annaburds/x-heep/tb/testharness_pkg.sv

// Copyright 2022 EPFL
// Solderpad Hardware License, Version 2.1, see LICENSE.md for details.
// SPDX-License-Identifier: Apache-2.0 WITH SHL-2.1

package testharness_pkg;

  import addr_map_rule_pkg::*;
  import core_v_mini_mcu_pkg::*;

  localparam EXT_XBAR_NMASTER = 5;
  localparam EXT_XBAR_NSLAVE = 2;

  //master idx
  localparam logic [31:0] EXT_MASTER0_IDX = 0;
  localparam logic [31:0] EXT_MASTER1_IDX = 1;
  localparam logic [31:0] EXT_MASTER2_IDX = 2;
  localparam logic [31:0] EXT_MASTER3_IDX = 3;
  localparam logic [31:0] EXT_MASTER4_IDX = 4;  // serial link external master

  //slave mmap and idx
  localparam logic [31:0] SLOW_MEMORY_START_ADDRESS = core_v_mini_mcu_pkg::EXT_SLAVE_START_ADDRESS+ 32'h0;
  localparam logic [31:0] SLOW_MEMORY_SIZE = 32'h200;
  localparam logic [31:0] SLOW_MEMORY_END_ADDRESS = SLOW_MEMORY_START_ADDRESS + SLOW_MEMORY_SIZE;
  localparam logic [31:0] SLOW_MEMORY_IDX = 32'd0;

  //slave sl
  localparam logic [31:0] SL_EXT_START_ADDRESS = core_v_mini_mcu_pkg::EXT_SLAVE_START_ADDRESS + 32'h10000;
  localparam logic [31:0] SL_EXT_SIZE = 32'h200;
  localparam logic [31:0] SL_EXT_END_ADDRESS = SL_EXT_START_ADDRESS + SL_EXT_SIZE;
  localparam logic [31:0] SL_EXT_IDX = 32'd1;


  localparam addr_map_rule_t [EXT_XBAR_NSLAVE-1:0] EXT_XBAR_ADDR_RULES = '{
      '{
          idx: SLOW_MEMORY_IDX,
          start_addr: SLOW_MEMORY_START_ADDRESS,
          end_addr: SLOW_MEMORY_END_ADDRESS
      },
      '{idx: SL_EXT_IDX, start_addr: SL_EXT_START_ADDRESS, end_addr: SL_EXT_END_ADDRESS}
  };

  //slave encoder
  localparam EXT_NPERIPHERALS = 5;

  // Memcopy controller (external peripheral example)
  localparam logic [31:0] MEMCOPY_CTRL_START_ADDRESS = core_v_mini_mcu_pkg::EXT_PERIPHERAL_START_ADDRESS + 32'h0;
  localparam logic [31:0] MEMCOPY_CTRL_SIZE = 32'h10;
  localparam logic [31:0] MEMCOPY_CTRL_END_ADDRESS = MEMCOPY_CTRL_START_ADDRESS + MEMCOPY_CTRL_SIZE;
  localparam logic [31:0] MEMCOPY_CTRL_IDX = 32'd0;

  // External AMS Peripheral
  localparam logic [31:0] AMS_START_ADDRESS = core_v_mini_mcu_pkg::EXT_PERIPHERAL_START_ADDRESS + 32'h01000;
  localparam logic [31:0] AMS_SIZE = 32'h100;
  localparam logic [31:0] AMS_END_ADDRESS = AMS_START_ADDRESS + AMS_SIZE;
  localparam logic [31:0] AMS_IDX = 32'd1;

  // External InterFaced FIFO (IFFIFO) Peripheral
  localparam logic [31:0] IFFIFO_START_ADDRESS = core_v_mini_mcu_pkg::EXT_PERIPHERAL_START_ADDRESS + 32'h02000;
  localparam logic [31:0] IFFIFO_SIZE = 32'h100;
  localparam logic [31:0] IFFIFO_END_ADDRESS = IFFIFO_START_ADDRESS + IFFIFO_SIZE;
  localparam logic [31:0] IFFIFO_IDX = 32'd2;

  // External Simple Accelerator Peripheral
  localparam logic [31:0] SIMPLE_ACC_START_ADDRESS = core_v_mini_mcu_pkg::EXT_PERIPHERAL_START_ADDRESS + 32'h03000;
  localparam logic [31:0] SIMPLE_ACC_SIZE = 32'h100;
  localparam logic [31:0] SIMPLE_ACC_END_ADDRESS = SIMPLE_ACC_START_ADDRESS + SIMPLE_ACC_SIZE;
  localparam logic [31:0] SIMPLE_ACC_IDX = 32'd3;
  localparam logic [31:0] SL_REG_START_ADDRESS= core_v_mini_mcu_pkg::EXT_PERIPHERAL_START_ADDRESS+ 32'h04000;
  localparam logic [31:0] SL_REG_SIZE = 32'h200;
  localparam logic [31:0] SL_REG_END_ADDRESS = SL_REG_START_ADDRESS + SL_REG_SIZE;
  localparam logic [31:0] SL_REG_IDX = 32'd4;

  localparam addr_map_rule_t [EXT_NPERIPHERALS-1:0] EXT_PERIPHERALS_ADDR_RULES = '{
      '{
          idx: MEMCOPY_CTRL_IDX,
          start_addr: MEMCOPY_CTRL_START_ADDRESS,
          end_addr: MEMCOPY_CTRL_END_ADDRESS
      },
      '{idx: AMS_IDX, start_addr: AMS_START_ADDRESS, end_addr: AMS_END_ADDRESS},
      '{idx: IFFIFO_IDX, start_addr: IFFIFO_START_ADDRESS, end_addr: IFFIFO_END_ADDRESS},
      '{
          idx: SIMPLE_ACC_IDX,
          start_addr: SIMPLE_ACC_START_ADDRESS,
          end_addr: SIMPLE_ACC_END_ADDRESS
      },
      '{idx: SL_REG_IDX, start_addr: SL_REG_START_ADDRESS, end_addr: SL_REG_END_ADDRESS}
  };

  localparam int unsigned EXT_PERIPHERALS_PORT_SEL_WIDTH = EXT_NPERIPHERALS > 1 ? $clog2(
      EXT_NPERIPHERALS
  ) : 32'd1;

endpackage
