annaburds/x-heep/sw/applications/example_seizureDetCNN_EE_avgPool_fc/main.c

// Porting to X-Heep : Francesco Poluzzi
/*
 *  Copyright (c) [2024] [Embedded Systems Laboratory (ESL), EPFL]
 *
 *  Licensed under the Apache License, Version 2.0 (the License);
 *  you may not use this file except in compliance with the License.
 *  You may obtain a copy of the License at
 *
 *      http://www.apache.org/licenses/LICENSE-2.0
 *
 *  Unless required by applicable law or agreed to in writing, software
 *  distributed under the License is distributed on an AS IS BASIS,
 *  WITHOUT WARRANTIES OR CONDITIONS OF ANY KIND, either express or implied.
 *  See the License for the specific language governing permissions and
 *  limitations under the License.
 */


//////////////////////////////////////////////////////
// Main Author:     Alireza Amirshahi               //
// Optimizations:   Dimitrios Samakovlis            //
/////////////////////////////////////////////////////



#include "main.h"
#include <stdio.h>
#include "timer_sdk.h"

// Enable the C level optimizations for performance gains (loop reordering - loop unrolling)
#define CONV_OPTIMIZED
#define CONV_MAX_OPTIMIZED	// this has the most significant gains as it is the most time consuming part
#define BATCH_OPTIMIZED

#define MAX_INT_16 65535

int16_t intermediate_map[256*128];

    
// ===========================> Functions Prototype <===============================
void conv1d(const int16_t *data, const signed char *filter, int16_t *map_out, const signed char *bias, int32_t filter_size,
            int32_t input_len, int32_t input_depth, int32_t output_len, int32_t n_filter, int32_t strides, int32_t relu);

void conv_max1d(const int16_t *data, const signed char *filter, int16_t *map_out, const signed char *bias,
                int32_t input_len, int32_t input_depth, int32_t output_len);

void batch_normalization(const int16_t *data, const signed char *gamma, const signed char *beta, const signed char *mean, const signed char *var,
                         int16_t *map_out, int32_t input_len);

int16_t forward_propagation(int16_t *data, int16_t *intermediate);

// =================================================================================

int main()
{
    #ifdef PRINT_CYCLES
        timer_init();
        timer_start();
    #endif

    int16_t predict = forward_propagation(input_array, intermediate_map);

    #ifdef PRINT_OUTPUT
    printf("Prediction : %d", predict);
    if (predict == 0)
        printf(" (Normal)\n");
    else
        printf(" (Seizure)\n");
    #endif

    #ifdef PRINT_CYCLES
        uint32_t cycles=timer_stop();
        printf("Cycles: %d\n",cycles);
    #endif
    
    return 0;
}


void conv1d(const int16_t * const data, const signed char * const filter, int16_t *map_out, const signed char * const bias, const int32_t filter_size,
            const int32_t input_len, const int32_t input_depth, const int32_t output_len, const int32_t n_filter, const int32_t strides,
            const int32_t relu) {
    register int32_t sum;
    int32_t mult;
    #ifndef CONV_OPTIMIZED
    int32_t pad = 0;
    
    for (int32_t w_n = 0; w_n < n_filter; w_n++) {
        for (int32_t start_index = 0; start_index < input_len; start_index += strides) {
            sum = 0;
            for (int32_t w_i = 0; w_i < filter_size; w_i++) {
                for (int32_t w_j = 0; w_j < input_depth; w_j++) {
                    if (start_index + w_i - pad < input_len && start_index + w_i - pad > -1) {
                        mult = MUL(mem3d(filter, filter_size, input_depth, w_n, w_j, w_i),
                                   mem2d(data, input_len, w_j, start_index + w_i - pad), NUM_FRACTION_CNV_FC);
			            sum += mult;
                    }
                }
            }
    #else
    for (int32_t start_index = 0; start_index < input_len; start_index += strides) {
	    register const signed char *filter_address = filter;		                                // Ali's optimization for faster addressing of filter elements
	    for (int32_t w_n = 0; w_n < n_filter; w_n++)    {
            sum = 0;
	        for (int32_t w_j = 0; w_j < input_depth; w_j++) {
                register const int16_t *data_address = &data[input_len * w_j + start_index];		// similar to Ali's optimization for faster addressing of data elements
                for (register int32_t w_i = 0; w_i < filter_size; w_i++) {
                    mult = MUL_CONV(*(filter_address++), *(data_address++), NUM_FRACTION_CNV_FC);
                    sum += mult;
                }
            }
    #endif
            sum += bias[w_n];

            if (relu && sum < 0)
                sum = 0; // Relu

            if (sum > (MAX_INT_16) )    {
                #ifdef PRINT_OVERFLOW
                printf("Overflow %d\n", sum);
                #endif
                sum = (MAX_INT_16) -1;
            }
            else if (sum < -(MAX_INT_16)){
                #ifdef PRINT_OVERFLOW
                printf("Overflow %d\n", sum);
                #endif
                sum = -(MAX_INT_16) +1;
            }
            mem2d(map_out, output_len, w_n, start_index / strides) = (int16_t) sum;

        }
    }
}


void conv_max1d(const int16_t * const data, const signed char * const filter, int16_t *map_out, const signed char * const bias,
                const int32_t input_len, const int32_t input_depth, const int32_t output_len) {
    register int32_t sum;
    register int32_t mult;
    
    #ifndef CONV_MAX_OPTIMIZED
    for (int32_t w_n = 0; w_n < 128; w_n++) {
        int32_t maximum = NEG_INF;
        for (int32_t start_index = 0; start_index < input_len; start_index++) {
            sum = 0;
            for (int32_t w_i = 0; w_i < 3; w_i++) {
                for (int32_t w_j = 0; w_j < input_depth; w_j++) {
                    if (start_index + w_i - 1 < input_len && start_index + w_i - 1 > -1) {
                        mult = MUL(mem3d(filter, 3, input_depth, w_n, w_j, w_i),
                                   mem2d(data, input_len, w_j, start_index + w_i - 1), NUM_FRACTION_CNV_FC);
			sum += mult;
                    }
                }
            }
             sum += bias[w_n];
	     
            if (sum > (MAX_INT_16) ){
                    sum = (MAX_INT_16) -1;
            }else if (sum < -(MAX_INT_16)){
                sum = -(MAX_INT_16) +1;
            }
            if (sum > maximum) {
                maximum = sum;
            }
            if (start_index % 4 == 3) {
                mem2d(map_out, output_len, w_n, start_index / 4) = (int16_t) maximum;
                maximum = NEG_INF;
            }
        }
    }
    #else
    
    int32_t maximum[128];
    
    for (int32_t w_n = 0; w_n < 128; w_n++) {
        maximum[w_n] = NEG_INF;
    }
    
    
    //loop 0 - unrolled
    register const signed char *filter_address = filter;
    for (int32_t w_n = 0; w_n < 128; w_n++) {
        sum = 0;
	    for (int32_t w_j = 0; w_j < input_depth; w_j++) {
            register const int16_t *data_address = &data[input_len * w_j];		// reset data address every time we go to a deeper layer
            filter_address++;
            // 1 to 3 since 1st is out of bound (padding)
            for (register int32_t w_i = 1; w_i < 3; w_i++) {
                mult = MUL_CONV(*(filter_address++), *(data_address++), NUM_FRACTION_CNV_FC);
                sum += mult;
            }
        }
        sum += bias[w_n];
            
        if (sum > (MAX_INT_16) ){
            #ifdef PRINT_OVERFLOW
            printf("Overflow %d\n", sum);
            #endif
            sum = (MAX_INT_16) -1;
        }
        else if (sum < -(MAX_INT_16)){
            #ifdef PRINT_OVERFLOW
            printf("Overflow %d\n", sum);
            #endif
            sum = -(MAX_INT_16) +1;
        }
        if (sum > maximum[w_n]) {
            maximum[w_n] = sum;
        }
    }
    
    for (int32_t start_index = 1; start_index < input_len - 1; start_index ++) {
        filter_address = filter;						// reset filter address every time we change position
        register int32_t offset = start_index - 1;						// precalculate this addition
        for (int32_t w_n = 0; w_n < 128; w_n++) {
            sum = 0;
            for (int32_t w_j = 0; w_j < input_depth; w_j++) {
                register const int16_t *data_address = &data[input_len * w_j + offset];		// reset data address every time we go to a deeper layer
                for (register int32_t w_i = 0; w_i < 3; w_i++) {
                    mult = MUL_CONV(*(filter_address++), *(data_address++), NUM_FRACTION_CNV_FC);
                    sum += mult;
                }
            }
            sum += bias[w_n];
            
            
            if (sum > (MAX_INT_16) ){
                sum = (MAX_INT_16) -1;
            }
            else if (sum < -(MAX_INT_16)){
                sum = -(MAX_INT_16) +1;
            }
            if (sum > maximum[w_n]) {
                maximum[w_n] = sum;
            }
            if (start_index % 4 == 3) {
                mem2d(map_out, output_len, w_n, start_index / 4) = (int16_t) maximum[w_n];
                maximum[w_n] = NEG_INF;
            }
        }
    }
    
    //last loop unrolled
    filter_address = filter;
    for (int32_t w_n = 0; w_n < 128; w_n++) {
        sum = 0;
	    for (int32_t w_j = 0; w_j < input_depth; w_j++) {
            register const int16_t *data_address = &data[input_len * w_j + input_len - 2];		// reset data address every time we go to a deeper layer
            // 0 to 2 since 3rd is out of bound (padding)
            for (register int32_t w_i = 0; w_i < 2; w_i++) {
                mult = MUL_CONV(*(filter_address++), *(data_address++), NUM_FRACTION_CNV_FC);
                sum += mult;
            }
            filter_address++;
        }
        sum += bias[w_n];
            
        if (sum > (MAX_INT_16) ){
            #ifdef PRINT_OVERFLOW
            printf("Overflow %d\n", sum);
            #endif
            sum = (MAX_INT_16) -1;
        }
        else if (sum < -(MAX_INT_16)){
            #ifdef PRINT_OVERFLOW
            printf("Overflow %d\n", sum);
            #endif
            sum = -(MAX_INT_16) +1;
        }
        if (sum > maximum[w_n]) {
            maximum[w_n] = sum;
        }
        if ((input_len - 1) % 4 == 3) {
            mem2d(map_out, output_len, w_n, (input_len - 1) / 4) = (int16_t) maximum[w_n];
            maximum[w_n] = NEG_INF;
        }
    }
    #endif
}

void batch_normalization(const int16_t *data, const signed char *gamma, const signed char *beta, const signed char *mean, const signed char *var,
                         int16_t *map_out, const int32_t input_len) {
#ifndef BATCH_OPTIMIZED
    for (int32_t start_index = 0; start_index < input_len; start_index++) {
        for (int32_t w_j = 0; w_j < 128; w_j++) {
            int16_t normalized = mem2d(data, input_len, w_j, start_index) -
            ((int16_t) mean[w_j] << (NUM_FRACTION_DATA - NUM_FRACTION_BN));
            int16_t standardized = MUL(normalized, var[w_j], NUM_FRACTION_BN);
            int16_t new_standardized = MUL(standardized, gamma[w_j], NUM_FRACTION_BN);
            mem2d(map_out, input_len, w_j, start_index) =
                    (int16_t) (new_standardized + ((int16_t) beta[w_j] << (NUM_FRACTION_DATA - NUM_FRACTION_BN)));
        }
    }
#else
    const int16_t *data_address = data;
    int16_t *map_out_address = map_out;
    for (int32_t w_j = 0; w_j < 128; w_j++) {
	for (int32_t start_index = 0; start_index < input_len; start_index++) {
            int16_t normalized = *(data_address++) -
		((int16_t) mean[w_j] << (NUM_FRACTION_DATA - NUM_FRACTION_BN));
            int16_t standardized = MUL(normalized, var[w_j], NUM_FRACTION_BN);
            int16_t new_standardized = MUL(standardized, gamma[w_j], NUM_FRACTION_BN);
            *(map_out_address++) =
                    (int16_t) (new_standardized + ((int16_t) beta[w_j] << (NUM_FRACTION_DATA - NUM_FRACTION_BN)));
        }
    }
#endif
}

void relu(int16_t * const data, int32_t input_len) {
    for (int32_t i = 0; i < input_len; i++)
        data[i] = (data[i] < 0) ? 0 : data[i];
}

void conv_block(const int32_t block, int16_t * const layer_in, int16_t * const conv1d_out){
    int32_t depth_size[6] = {23, 128, 128, 128, 100, 2};
    int32_t map_size[6] = {1024, 256, 64, 16, 1, 1};
    signed char* filter = conv1d_w[block];
    signed char* bias = conv1d_b[block];

    conv_max1d(layer_in, filter, conv1d_out, bias, map_size[block], depth_size[block], map_size[block+1]);
    
    batch_normalization(conv1d_out, bn[block * 4], bn[block * 4 + 1], bn[block * 4 + 2], bn[block * 4 + 3],
                        conv1d_out, map_size[block+1]);

    printf("CONV block %d mapsize %d depth %d \n\r",block, map_size[block+1],depth_size[block + 1]);
    relu(conv1d_out, map_size[block+1] * depth_size[block + 1]);
}

void adaptive_avg_pool_1d(float* input, float* output, int n_channels, int input_size) {
    for (int c = 0; c < n_channels; c++) {
        float sum = 0.0;
        for (int i = 0; i < input_size; i++) {
            sum += input[c * input_size + i];
        }
        output[c] = sum / input_size;
    }
}

int16_t forward_propagation(int16_t *data, int16_t *intermediate) {
    int32_t fc_depth_size[3] = {128, 100, 2};
    int32_t fc_map_size[3] = {16, 1, 1};
    int16_t* intermediate_map0 = intermediate;
    int16_t* intermediate_map1 = data;
    //heep_kResults[kResultsIdx++] = 11;

    //  ************  BLOCK 0  ************ //
    int16_t *layer_out = intermediate_map0;
    int16_t *layer_in = intermediate_map1;
    unsigned int cycles1;
    CSR_CLEAR_BITS(CSR_REG_MCOUNTINHIBIT, 0x1);
    CSR_WRITE(CSR_REG_MCYCLE, 0);
    conv_block(0, layer_in, layer_out);
    CSR_READ(CSR_REG_MCYCLE, &cycles1);
    printf("CONV 0 -  %d cycles\n\r", cycles1);
    //heep_kResults[kResultsIdx++] = 110;
    


    //Early Exit Branch
    int16_t *input_ee = layer_out;
    int16_t *output_ee = layer_out;
    adaptive_avg_pool_1d(input_ee,output_ee,256*,256*128*64);
    
    
    
    //  ************  BLOCK 1  ************ //
    layer_out = intermediate_map1;
    layer_in = intermediate_map0;
    CSR_CLEAR_BITS(CSR_REG_MCOUNTINHIBIT, 0x1);
    CSR_WRITE(CSR_REG_MCYCLE, 0);
    conv_block(1, layer_in, layer_out);
    CSR_READ(CSR_REG_MCYCLE, &cycles1);
    printf("CONV 0 -  %d cycles\n\r", cycles1);
    //heep_kResults[kResultsIdx++] = 1110;
    
    //  ************  BLOCK 2  ************ //
    layer_out = intermediate_map0;
    layer_in = intermediate_map1;
    CSR_CLEAR_BITS(CSR_REG_MCOUNTINHIBIT, 0x1);
    CSR_WRITE(CSR_REG_MCYCLE, 0);
    conv_block(2, layer_in, layer_out);
    CSR_READ(CSR_REG_MCYCLE, &cycles1);
    printf("CONV 2 -  %d cycles\n\r", cycles1);
    
    //  ************  FC 0  ************ //
    layer_out = intermediate_map1;
    layer_in = intermediate_map0;
    CSR_CLEAR_BITS(CSR_REG_MCOUNTINHIBIT, 0x1);
    CSR_WRITE(CSR_REG_MCYCLE, 0);
    conv1d(layer_in, dense_w[0], layer_out, dense_b[0], fc_map_size[0],fc_map_size[0],
           fc_depth_size[0], fc_map_size[1], fc_depth_size[1], fc_map_size[0], 1);
    CSR_READ(CSR_REG_MCYCLE, &cycles1);
    printf("FC 0 -  %d cycles\n\r", cycles1);
    #ifdef PRINT_FC0_OUT
    printf("\nFC 0 out:\n");
    for(int i=0; i< fc_depth_size[1]*fc_map_size[0]; i++)
	    printf("%d ", layer_out[i]);
    printf("\n");
    #endif
    
    //  ************  FC 1  ************ //
    layer_out = intermediate_map0;
    layer_in = intermediate_map1;
    CSR_CLEAR_BITS(CSR_REG_MCOUNTINHIBIT, 0x1);
    CSR_WRITE(CSR_REG_MCYCLE, 0);
    conv1d(layer_in, dense_w[1], layer_out, dense_b[1], fc_map_size[1],fc_map_size[1],
           fc_depth_size[1], fc_map_size[2], fc_depth_size[2], fc_map_size[1], 0);
    CSR_READ(CSR_REG_MCYCLE, &cycles1);
    printf("FC 1 -  %d cycles\n\r", cycles1);
    #ifdef PRINT_FC1_OUT
    printf("\n\nFC 1 out:\n");
    for(int i=0; i< fc_depth_size[2]*fc_map_size[1]; i++)
	    printf("%d ", layer_out[i]);
    printf("\n");
    #endif

    if (layer_out[0] > layer_out[1])
        return 0;
    else
        return 1;
}
