annaburds/x-heep/sw/applications/example_dlc_internal/test_ecg.h

/*
 *  Copyright EPFL contributors.
 *  Licensed under the Apache License, Version 2.0, see LICENSE for details.
 *  SPDX-License-Identifier: Apache-2.0
 *
 */
/**
* @file   test_ecg.h
* @brief  
	ECG, sampled at 5 kHz.
	The data is encoded in 12 bits, signed, of amplitude 2047 LSBs
	The input data has a data rate of 60 kbps
	The signal is passed through a digital LC (dLC) block. 
	Each level is 16 LSBs wide (i.e. the 4 less significant bits are ignored).
* @date   2025-04-02
* @author Juan Sapriza (juan.sapriza@epfl.ch)
taken from: Moody, George B., and Roger G. Mark. "MIT-BIH arrhythmia database." (1992).
*/

#ifndef _ECG_LC_H_
#define _ECG_LC_H_ 

#include <stdint.h>


#define LC_PARAMS_LC_LSBS_TO_USE_AS_HYSTERESIS 0
#define LC_PARAMS_LC_LEVEL_WIDTH_BY_BITS 4
#define LC_PARAMS_DATA_IN_TWOS_COMPLEMENT 0
#define LC_PARAMS_LC_ACQUISITION_WORD_SIZE_OF_AMPLITUDE 2
#define LC_PARAMS_LC_ACQUISITION_WORD_SIZE_OF_TIME 6
#define LC_PARAMS_LC_LEVEL_WIDTH_BY_FRACTION 256
#define LC_PARAMS_SIZE_PER_SAMPLE_BITS 8
#define LC_STATS_CROSSINGS 333
#define LC_STATS_D_LVL_OVERFLOW_WORDS 49
#define LC_STATS_D_T_OVERFLOW_WORDS 14
#define FORM_STATS_WORD_SIZE_BITS 8


int16_t ecg_data [3748] = {0, 1, 2, 3, 4, 5, 6, 7, 8, 9, 10, 11, 13, 14, 15, 16, 17, 18, 19, 20, 21, 22, 22, 23, 23, 24, 24, 25, 25, 26, 27, 27, 28, 28, 29, 29, 30, 30, 31, 31, 32, 32, 32, 33, 33, 33, 34, 34, 34, 34, 35, 35, 35, 35, 36, 36, 36, 37, 37, 37, 37, 37, 37, 37, 37, 37, 37, 37, 37, 37, 37, 37, 37, 37, 37, 37, 37, 37, 37, 37, 37, 38, 39, 40, 41, 41, 42, 43, 44, 45, 46, 46, 47, 48, 49, 50, 50, 51, 52, 53, 54, 54, 55, 55, 56, 56, 57, 57, 58, 58, 59, 60, 60, 61, 61, 62, 62, 63, 63, 64, 64, 65, 65, 66, 67, 67, 68, 68, 69, 69, 70, 70, 71, 71, 72, 72, 73, 74, 74, 75, 75, 75, 74, 74, 74, 74, 73, 73, 73, 72, 72, 72, 72, 71, 71, 71, 71, 70, 70, 70, 70, 71, 73, 74, 75, 77, 78, 79, 81, 82, 83, 85, 86, 87, 89, 90, 91, 93, 94, 95, 97, 98, 99, 101, 102, 104, 105, 106, 108, 109, 110, 112, 113, 114, 116, 117, 118, 120, 121, 123, 123, 123, 122, 122, 121, 121, 120, 119, 119, 118, 118, 117, 117, 116, 116, 115, 115, 114, 114, 113, 113, 112, 112, 112, 112, 111, 111, 111, 111, 110, 110, 110, 109, 109, 109, 109, 108, 108, 108, 108, 108, 109, 110, 112, 113, 114, 116, 117, 118, 120, 121, 123, 124, 125, 127, 128, 129, 131, 132, 133, 135, 135, 136, 136, 137, 137, 138, 138, 139, 139, 140, 141, 141, 142, 142, 143, 143, 144, 144, 145, 145, 145, 145, 144, 144, 144, 143, 143, 143, 143, 142, 142, 142, 142, 141, 141, 141, 141, 140, 140, 139, 138, 136, 135, 134, 132, 131, 129, 128, 127, 125, 124, 123, 121, 120, 119, 117, 116, 114, 113, 113, 113, 114, 114, 114, 114, 115, 115, 115, 115, 116, 116, 116, 1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

#endif // _ECG_LC_H_ 
