annaburds/x-heep/sw/applications/example_serial_link_fpga_receiver/timer_util.c

// Copyright 2023 EPFL and Politecnico di Torino.
// Solderpad Hardware License, Version 2.1, see LICENSE.md for details.
// SPDX-License-Identifier: Apache-2.0 WITH SHL-2.1
//
// File: timer_util.c
// Author: Michele Caon
// Date: 31/07/2023
// Description: Timer functions

#include <stdint.h>

#include "timer_util.h"
#include "csr.h"

/******************************/
/* ---- GLOBAL VARIABLES ---- */
/******************************/

// Timer value
uint32_t timer_value = 0;
uint32_t hw_timer_value = 0;

rv_timer_t timer;

rv_timer_config_t timer_cfg = {
    .hart_count = RV_TIMER_PARAM_N_HARTS,
    .comparator_count = RV_TIMER_PARAM_N_TIMERS,
};

mmio_region_t timer_base = {
    .base = (void *)RV_TIMER_AO_START_ADDRESS,
};

rv_timer_tick_params_t tick_params;

/*************************************/
/* ---- FUNCTION IMPLEMENTATION ---- */
/*************************************/

// Initialize the hardware timer
void hw_timer_init()
{
    // Initialize the timer
    rv_timer_init(timer_base, timer_cfg, &timer);
    rv_timer_approximate_tick_params(REFERENCE_CLOCK_Hz, REFERENCE_CLOCK_Hz, &tick_params);
    rv_timer_set_tick_params(&timer, 0, tick_params);
    rv_timer_counter_set_enabled(&timer, 0, true);
}

uint32_t hw_timer_get_cycles()
{
    uint64_t cycle_count;
    rv_timer_counter_read(&timer, 0, &cycle_count);
    return (uint32_t)cycle_count;
}

void hw_timer_start()
{
    hw_timer_value = -hw_timer_get_cycles();
}

uint32_t hw_timer_stop()
{
    hw_timer_value += hw_timer_get_cycles();
    return hw_timer_value;
}

// Initialize the timer
void timer_init()
{
    // Enable MCYCLE counter
    CSR_CLEAR_BITS(CSR_REG_MCOUNTINHIBIT, 0x1);
}
