annaburds/x-heep/(commit log)

2024-08-21 fixed xilinx wrapper. sim^em work
    [main.c, testharness.sv, timer_util.c, timer_util.h, xilinx_core_v_mini_mcu_wrapper.sv]
2024-08-28 fixed xilinx core wrapper
    [xilinx_core_v_mini_mcu_wrapper.sv]
2024-08-29 2xheep seizure conv (correctly sends)
    [main.c, pin_assign.xdc, xilinx_core_v_mini_mcu_wrapper.sv]
2024-09-18 dma save example single data
2024-09-27 replace double access with fifo
    [fifo_serial_link_wrapper.sv, main.c]
2024-10-02 dma save example with fifo
2024-10-08 fix fifo wrapper and dma examples
    [core_v_mini_mcu.sv, fifo_serial_link_wrapper.sv, main.c]
2024-10-09 dma receiver and sender
2024-11-17 Move fifo_wrapper into sl_wrapper. TODO:Connect the axi signal directly to the writer of the fifo_wrapper, skipping cdc and axi_to_mem.
    [core_v_mini_mcu.sv, fifo_serial_link_wrapper.sv, testharness.sv]
2024-11-19 skip cdc and axi_to_mem
    [main.c]
2024-11-22 bind fifo full and empty signals to leds on board
2024-11-29 update constraints, insert ila
2024-12-19 update reg to fix bitwidth misalignment warning
    [core_v_mini_mcu.sv, testharness.sv]
